monideepbora/neorv32/sw/README.md

## NEORV32 Software Framework

This folder provides the core of the NEORV32 software framework. This is a short description of the main folders.
### [`common`](https://github.com/stnolting/neorv32/tree/master/sw/common)

NEORV32-specific common files for all bootloader and application programs: linker script for executable generation and
processor start-up code.

### [`application`](https://github.com/stnolting/neorv32/tree/master/sw/example)

Several example programs for testing and for getting started.

### [`image_gen`](https://github.com/stnolting/neorv32/tree/master/sw/image_gen)

This folder contains a simple program that is used to create NEORV32 executables (for upload via bootloader) and VHDL memory
initializiation files (for memory-persistent applications and for the bootloader). This program is automatically compiled using
the native GCC when invoking one of the application compilation makefiles.

### [`lib`](https://github.com/stnolting/neorv32/tree/master/sw/lib)

Core libraries (sources and header files) and helper functions for using the processor peripherals and the CPU itself.
<!--  -->
