monideepbora/neorv32/sw/application/rvtests/main.c

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

/**********************************************************************//**
 * @file hello_world/main.c
 * @author Stephan Nolting
 * @brief Classic 'hello world' demo program.
 **************************************************************************/

#include <neorv32.h>


/**********************************************************************//**
 * @name User configuration
 **************************************************************************/
/**@{*/
/** UART BAUD rate */
#define BAUD_RATE 19200
/**@}*/



/**********************************************************************//**
 * Main function; prints some fancy stuff via UART.
 *
 * @note This program requires the UART interface to be synthesized.
 *
 * @return Irrelevant.
 **************************************************************************/
int main() {

  // capture all exceptions and give debug info via UART
  // this is not required, but keeps us safe
  neorv32_rte_setup();

  // init UART at default baud rate, no parity bits, no rx interrupt, no tx interrupt
  neorv32_uart_setup(BAUD_RATE, 0b00, 0, 0);

  // check available hardware extensions and compare with compiler flags
  //neorv32_rte_check_isa(0); // silent = 0 -> show message if isa mismatch

  // print project logo via UART
  //neorv32_rte_print_logo();

  // say hello
  neorv32_uart_print("Executing test! :)\n");

  __asm__ volatile("j start;"); //jump to riscv-tests

  return 0;
}

//console functions to output tests status
void success()
{
    //neorv32_uart_putc('\n');
    neorv32_uart_print("Success \n$");
}

void failure()
{
    neorv32_uart_print("..Failure\n$"); 
}

void OK()
{
    neorv32_uart_print("..OK\n");
}
