monideepbora/neorv32/(commit log)

2021-02-13 added riscv tests - not working
    [main.c, neorv32_cpu.vhd]
2021-03-07 reverted the IMEM size
    [neorv32_dmem.vhd, neorv32_tb.vhd, neorv32_top.vhd]
